0xgui/pico-self-rising-robot/3Dmodel/armhornP.stl

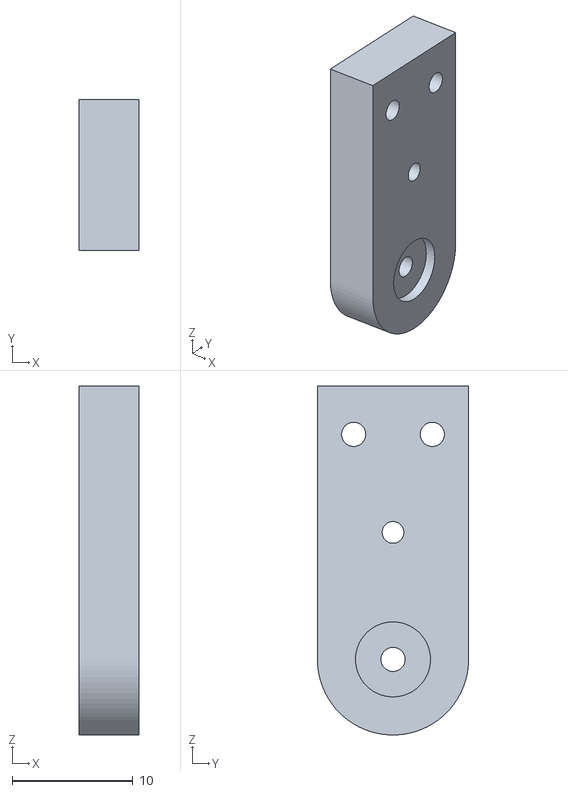
[picture p4: CAD file, 2026-09-23]
3Dmodel/armhornP.stl
5.00 x 12.5 x 28.9
