0xgui/pico-self-rising-robot/RL/assets/ATOM.stl

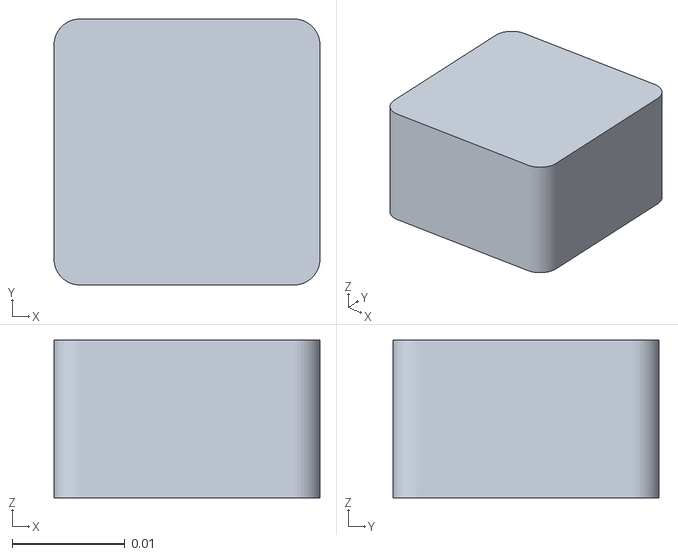
[picture p5: CAD file, 2026-09-23]
RL/assets/ATOM.stl
0.0236 x 0.0236 x 0.014
