0xgui/pico-self-rising-robot/3Dmodel/footP.stl

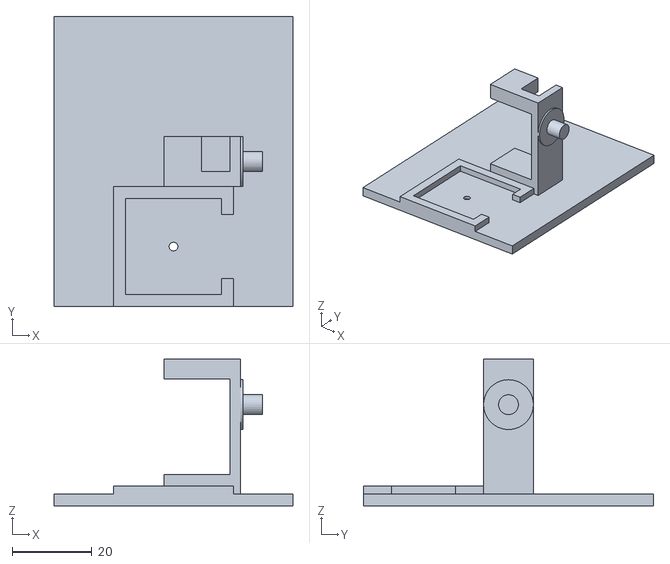
[picture p6: CAD file, 2026-09-23]
3Dmodel/footP.stl
60.0 x 72.9 x 36.8
