0xgui/pico-self-rising-robot/RL/assets/arm1.stl

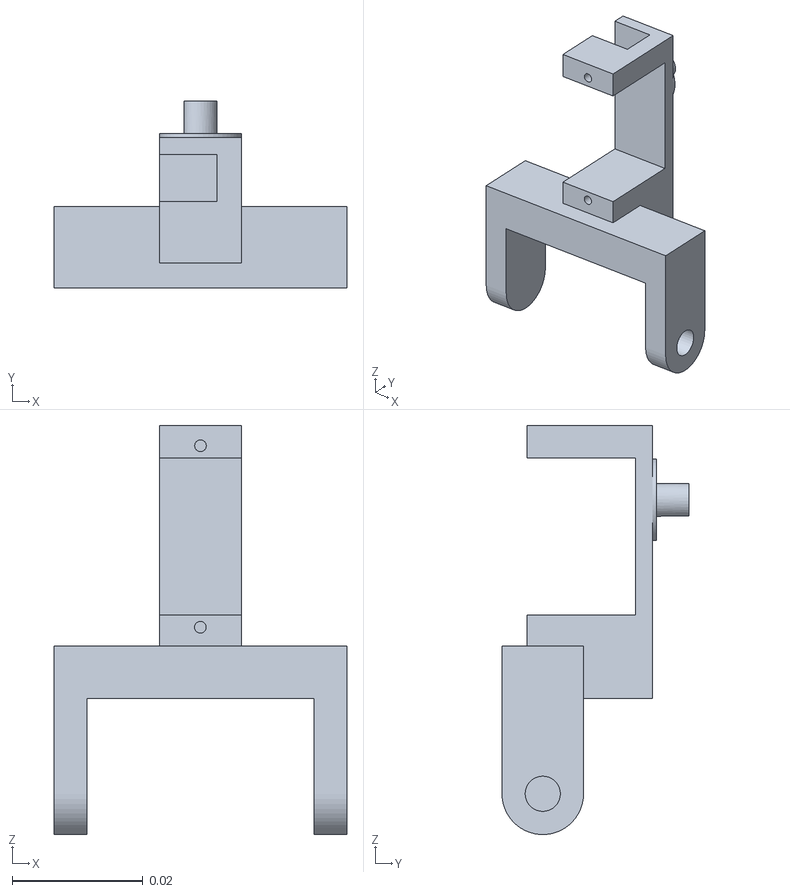
[picture p7: CAD file, 2026-09-23]
RL/assets/arm1.stl
0.0448 x 0.0287 x 0.0626
