0xgui/pico-self-rising-robot/3Dmodel/arm2P.stl

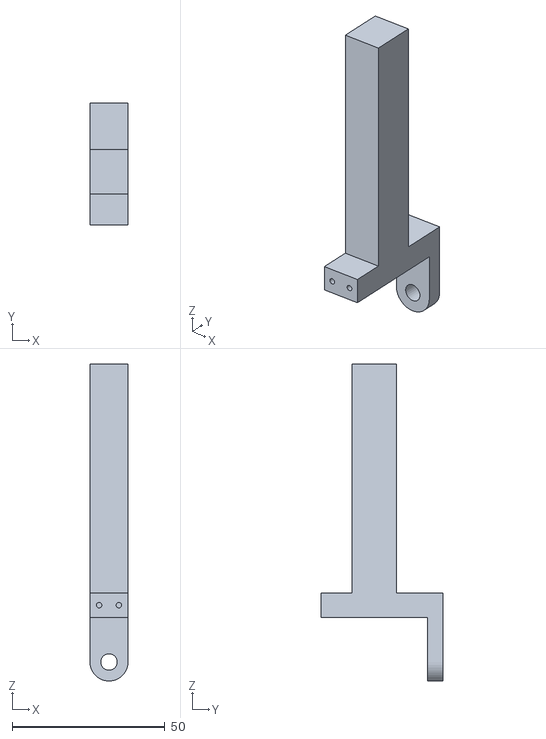
[picture p8: CAD file, 2026-09-23]
3Dmodel/arm2P.stl
12.5 x 39.8 x 103.8
