0xgui/pico-self-rising-robot/RL/assets/servo1.stl

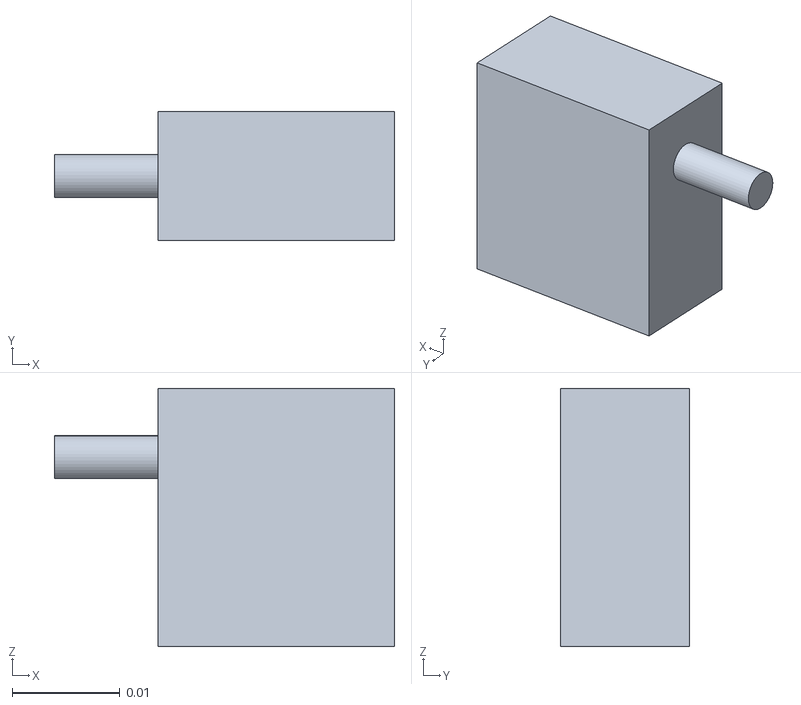
[picture p9: CAD file, 2026-09-23]
RL/assets/servo1.stl
0.0316 x 0.012 x 0.024
