0xgui/pico-self-rising-robot/3Dmodel/arm1P.stl

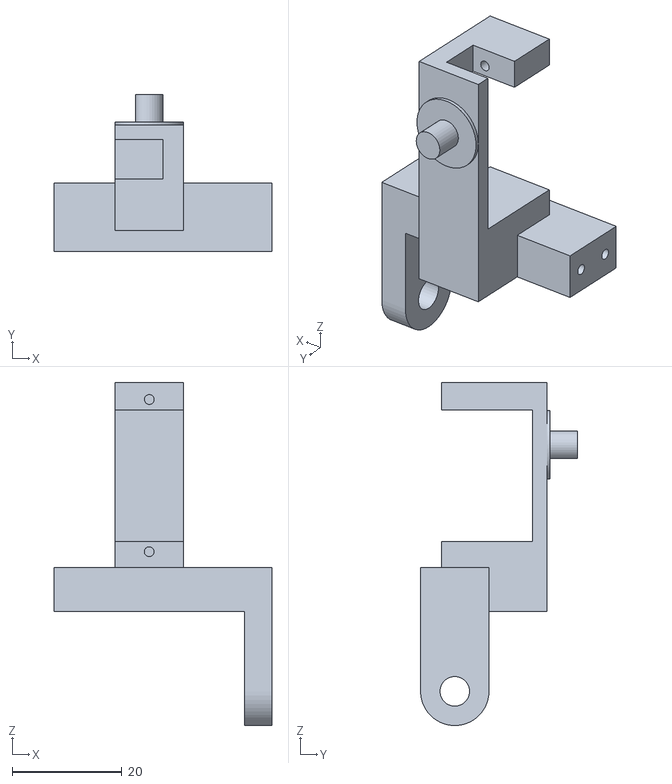
[picture p10: CAD file, 2026-09-23]
3Dmodel/arm1P.stl
39.8 x 28.7 x 62.6
