0xgui/pico-self-rising-robot/RL/assets/arm2.stl

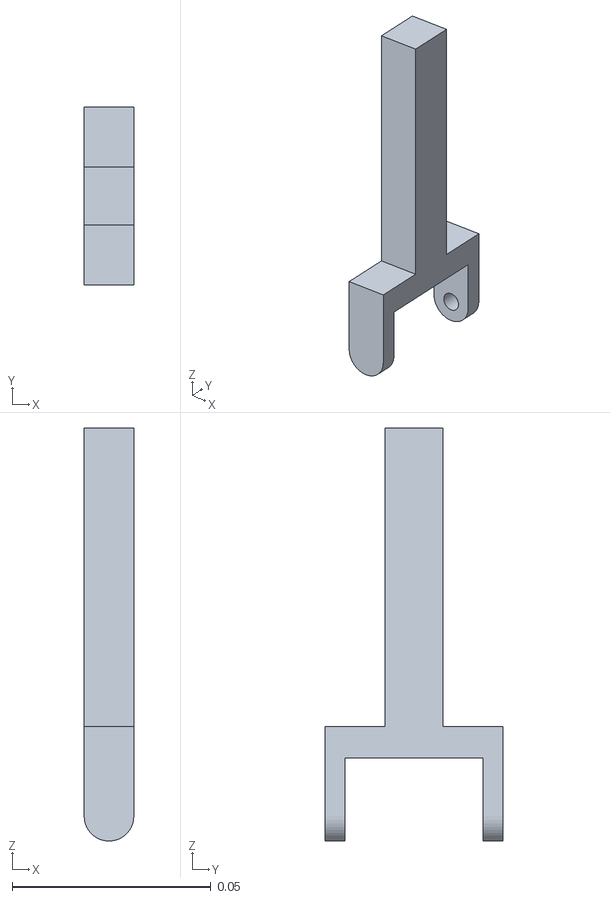
[picture p11: CAD file, 2026-09-23]
RL/assets/arm2.stl
0.0125 x 0.0448 x 0.104
