0xgui/pico-self-rising-robot/RL/assets/foot.stl

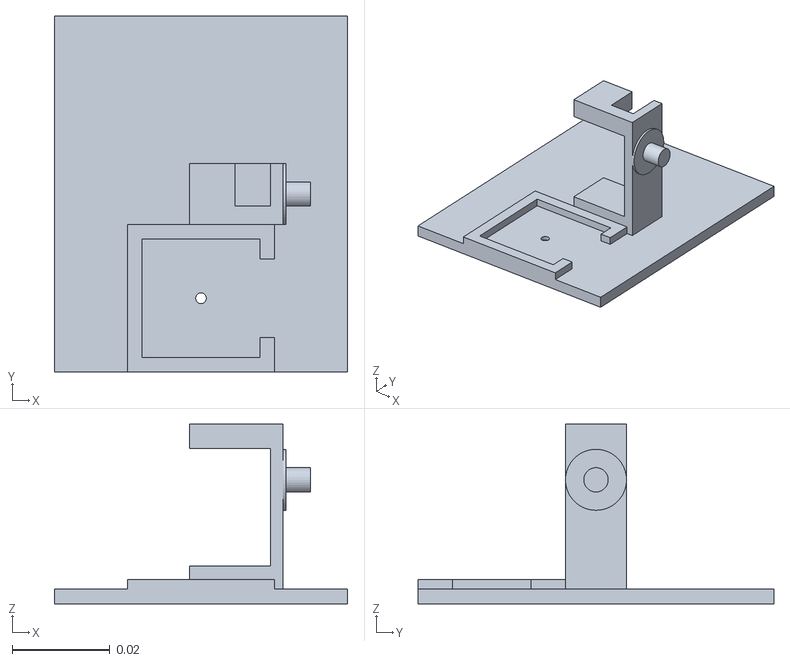
[picture p12: CAD file, 2026-09-23]
RL/assets/foot.stl
0.06 x 0.0729 x 0.0368
