0xgui/pico-self-rising-robot/(list of files, cad)

Other CAD files:
RL/assets/servo2.stl
