0xgui/pico-self-rising-robot/(commit log)

2026-09-23 Initial public snapshot: pico robot build
    [ATOM.stl, arm1.stl, arm1P.stl, arm2.stl, arm2P.stl, armhornP.stl, foot.stl, footP.stl]
2026-10-15 Shrink README media and fix IMU GIF alt text
